mehmethakanyel/Flytech/WhatsApp Image 2023-06-27 at 12.40.13.jpeg

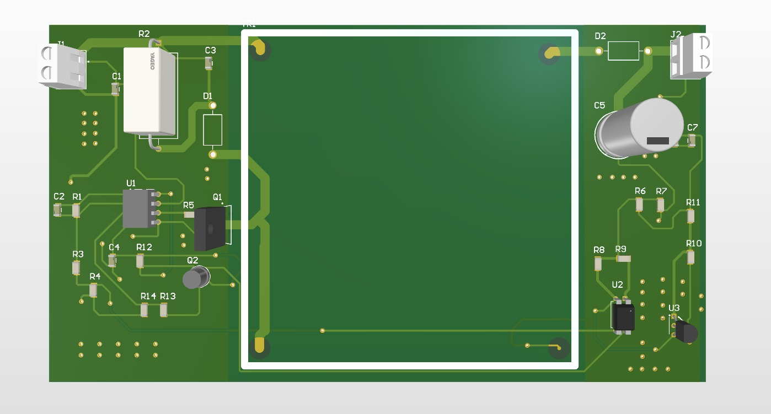
WhatsApp Image 2023-06-27 at 12.40.13.jpeg
