mehmethakanyel/Flytech/README.md

# Flytech
Simulation report: https://docs.google.com/document/d/1wn0tQVHkpxJtkFoidh_2tNkKYAAwz3BNU8IfM2yoR5c/edit#
Final report:  https://docs.google.com/document/d/1T_zZ1rMvK4J-9SenWcKEVHj9yXU3YNR3/edit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
