mehmethakanyel/Flytech/Final_report_magnetic_design.docx

### Core

The core is selected as 00K3515E090 [1]. Our converter has high frequency with a small number of turns, which means the core losses are expected to be the dominant power dissipation component. E cores are better at radiating the core losses than toroid cores albeit worse at radiating the copper losses. Therefore, an E core with the smallest size in the stock is selected.

### Turns Ratio and Magnetizing Inductance

If the duty cycle is assumed to be 0.4, switching frequency 100 kHz and efficiency 0.85, then

V_o =(N_2)/(N_1)(DV_(in))/(1-D)η=(N_2)/(N_1)(0.4⋅12)/0.60.85=48

(N_2)/(N_1)=7

I_(Lm,on) =(P_o)/η/V_(in) D=(48_o)/0.85/12⋅0.4=11.8A

If turns are taken as N_1 =5 , N_2 =35 :

I_1 N_1 =11.8⋅5=59AT

At which point, A_L =135nH/T^2

L_m =A_L N_1 ^2 =3.375μH

In order to stay in CCM:

L_(m,min) =((1-D)^2 R)/(2f)((N_1)/(N_2))^2 =((0.6)^2 48)/(200k)(1/7)^2 =1.76μH<3.375μH

### Wire Selection

Primary RMS current is calculated as,

I_(1,rms) =√(I^2 _(Lm,on) D)=7.46A
I_(2,rms) =√(I ^2 _(Lm,off) (1-D))=1.29A

Accordingly, the primary wire is selected as 18 AWG and the secondary 20 AWG. In this case, primary current density is 9.5A/mm^2 and secondary current density is 0.69A/mm^2 . Fill factor is calculated as:

TA/W_a =(35⋅0.5+5⋅0.79)/151=14%

which is much smaller than 1.

DC resistance of the primary wire:

l_1 =2(C+F)N_1 =2(9.35+9.32)⋅5=186.7mm

l_2 =2(C+F)N_2 =2(9.35+9.32)⋅35=1306.9mm

R_(1,DC) =l_1 R_(cu) /l=186.7mm⋅21Ω/km=3.9mΩ

R_(2,DC) =l_2 R_(cu) /l=1306.9mm⋅33Ω/km=43mΩ

δ=75/√f=0.237mm

R_(1,AC) ≃R_(1,DC) =5.9mΩ

R_(2,AC) ≃R_(2,DC) =54mΩ

P_(cu) =P_(1,cu) +P_(2,cu) =R_(1,AC) I^2 _(1,rms) +R_(2,AC) I^2 _(2,rms) =0.0059⋅7.46^2 +0.054⋅1.29^2 =0.42W

Core losses per volume per 100mT at 100kHz is given as 0.8W/cm^3 =0.8mW/mm^3 .

ΔI_(Lm) =V_(in) D/fL_m =12⋅0.4/100k⋅3.375μ=14.2A

ΔB=Δϕ/A_e =Δλ/NA_e =ΔI_(Lm) L_m /NA_e =14.2A⋅3.375μH/5⋅84mm^2 =114mT

P_(fe) =0.8mW/mm^3 ⋅ΔB/100mT⋅V_e =0.8mW/mm^3 ⋅114mT/100mT⋅5830mm^3 =5.32W

As was expected, at such a high frequency, core losses are larger than copper losses and need E core to dissipate its heat. However, the optimum point of operation, where copper losses are equal to the core losses, can be achieved by decreasing the frequency.S

### Test Results

Once the transformer is wound according to the proposed parameters, it is no-load and short-circuit tested from both sides and the results are the following:

Primary no-load test:

L_(1l) +L_(1m) =5.73μH R_1 =0.0747Ω

Primary short-circuit test:

L_(1l) =0.39μH

Secondary no-load test:

L_(2l) +L_(2m) =286μH R_2 =1.8Ω

Secondary short-circuit test:

L_(2l) =29.2μH

Accordingly, transformer parameters are calculated as follows:

L_(1l) =0.39μH L_m =5.34μH

L_(2l) =29.2μH (N_2)/(N_1)=7

Apparently, leakage inductances are around 10% of the magnetizing inductance, which is acceptable if a suitable snubber is selected. Resistances are also measured to be much higher than calculated. The reason might be the proximity effect which is effective in high frequencies, or due to the neglected core resistance.
