mehmethakanyel/Flytech/Nonideal_simulation.docx

Circuit Simulation with Non Ideal Elements

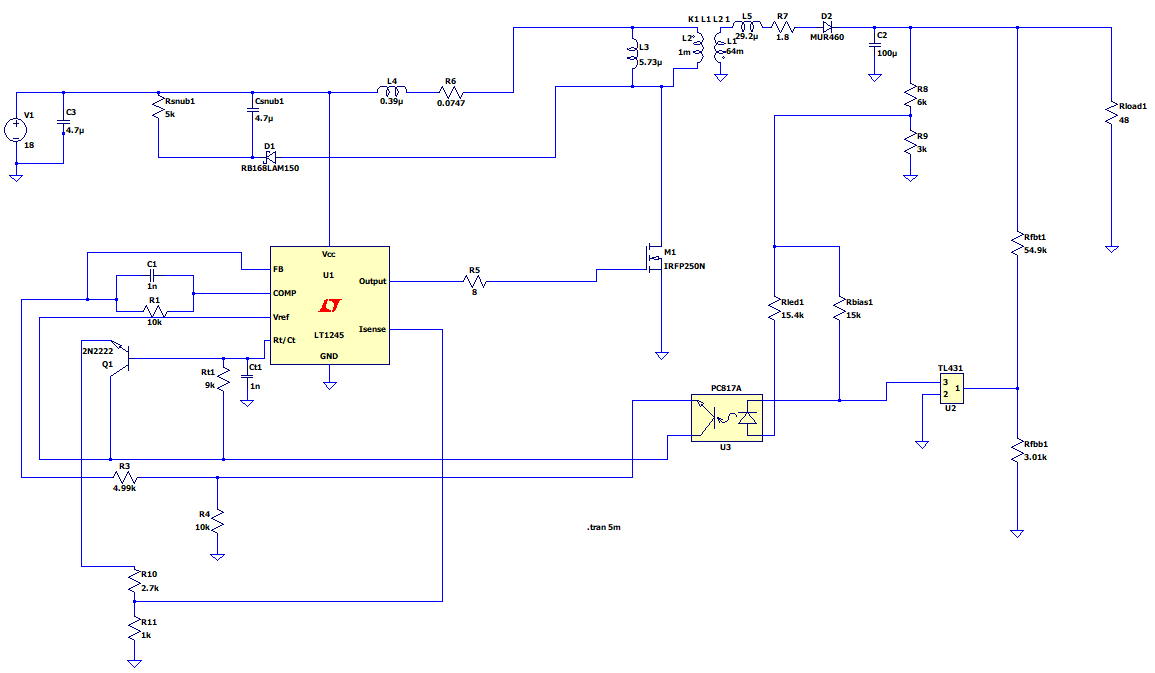
[picture p30: figure]

Fig. 18 Circuit Schematic with Non-Ideal Components

The circuit in Figure 18 is simulated. The controller model LT1245 in the simulation is the equivalent of our controller UC3845. As seen from Figure 20, the output voltage reaches 48V in less than 3ms. Maximum and minimum values are shown in Figure 21, in which the ripple is less than 2%.

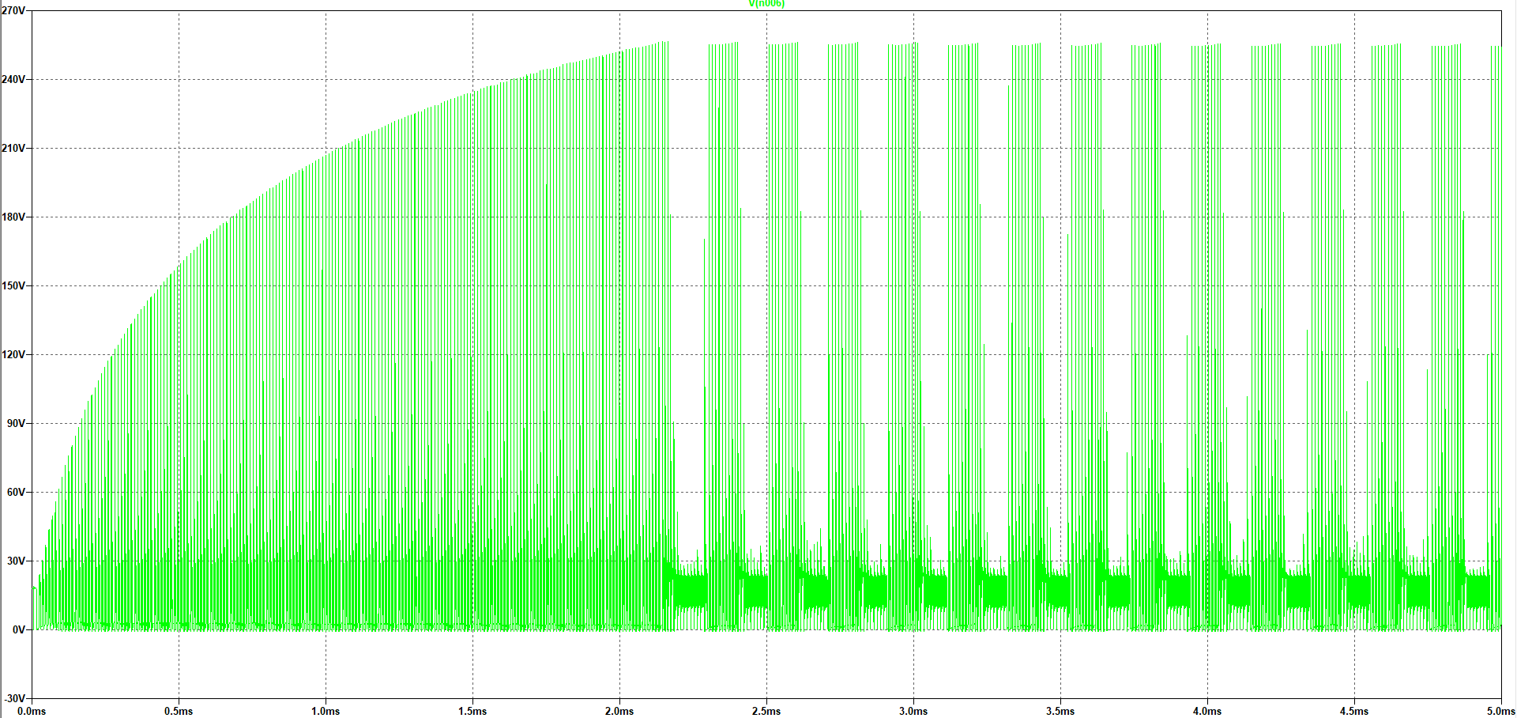
[picture p31: figure]

Fig. 19 MOSFET Drain-Source Voltage

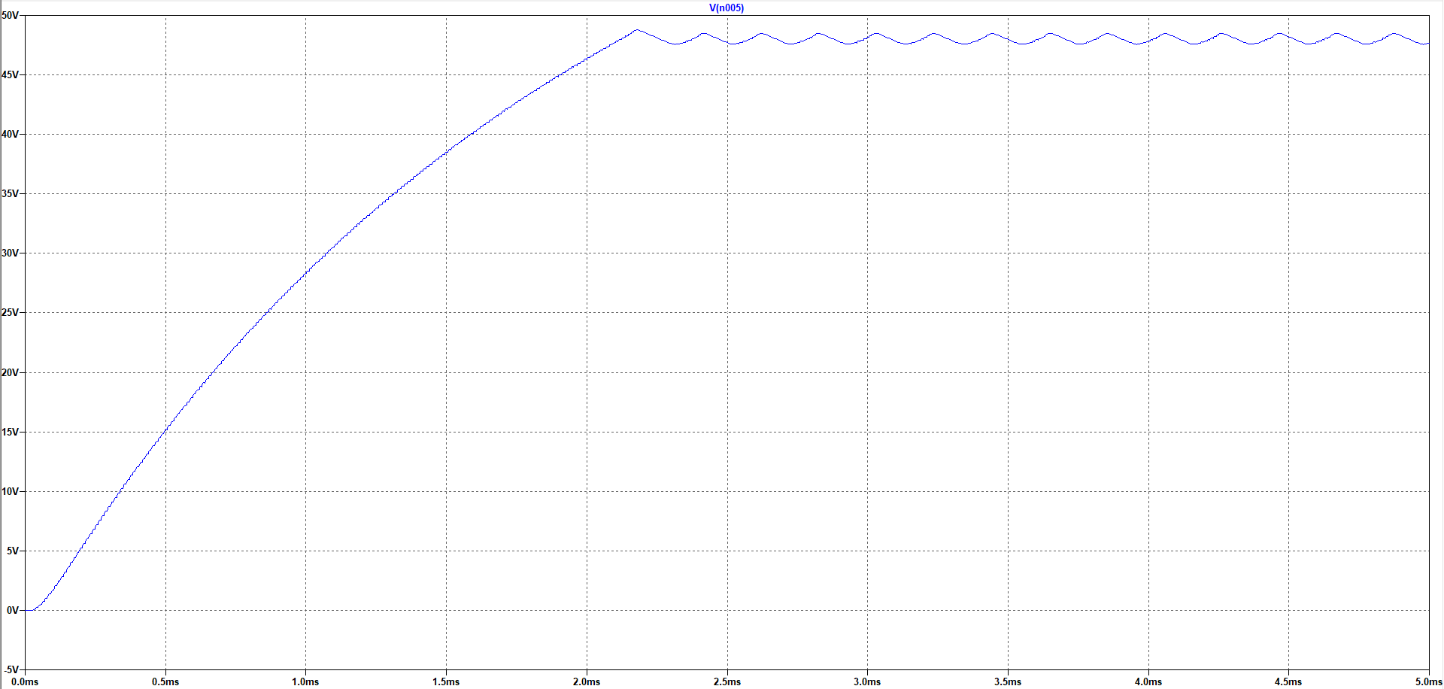
[picture p32: figure]

Fig. 20 Output Voltage Transient

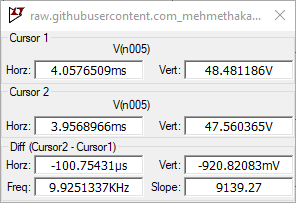
[picture p33: figure]

Fig. 26 Output Voltage Data
