mehmethakanyel/Flytech/Project_report_controller_components.docx

UCx84x Current-Mode PWM Controllers

In this section controller is introduced and circuit calculations are made.

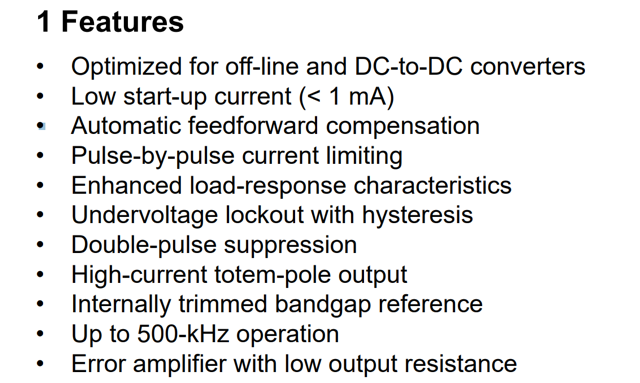
[picture p34: figure]

This controller produced by Texas Instruments however many manufacturers produce the exact product. Analog Devices is one of them it helps us the simulate this circuit with LTspice.

Figure 1: Features and Applications

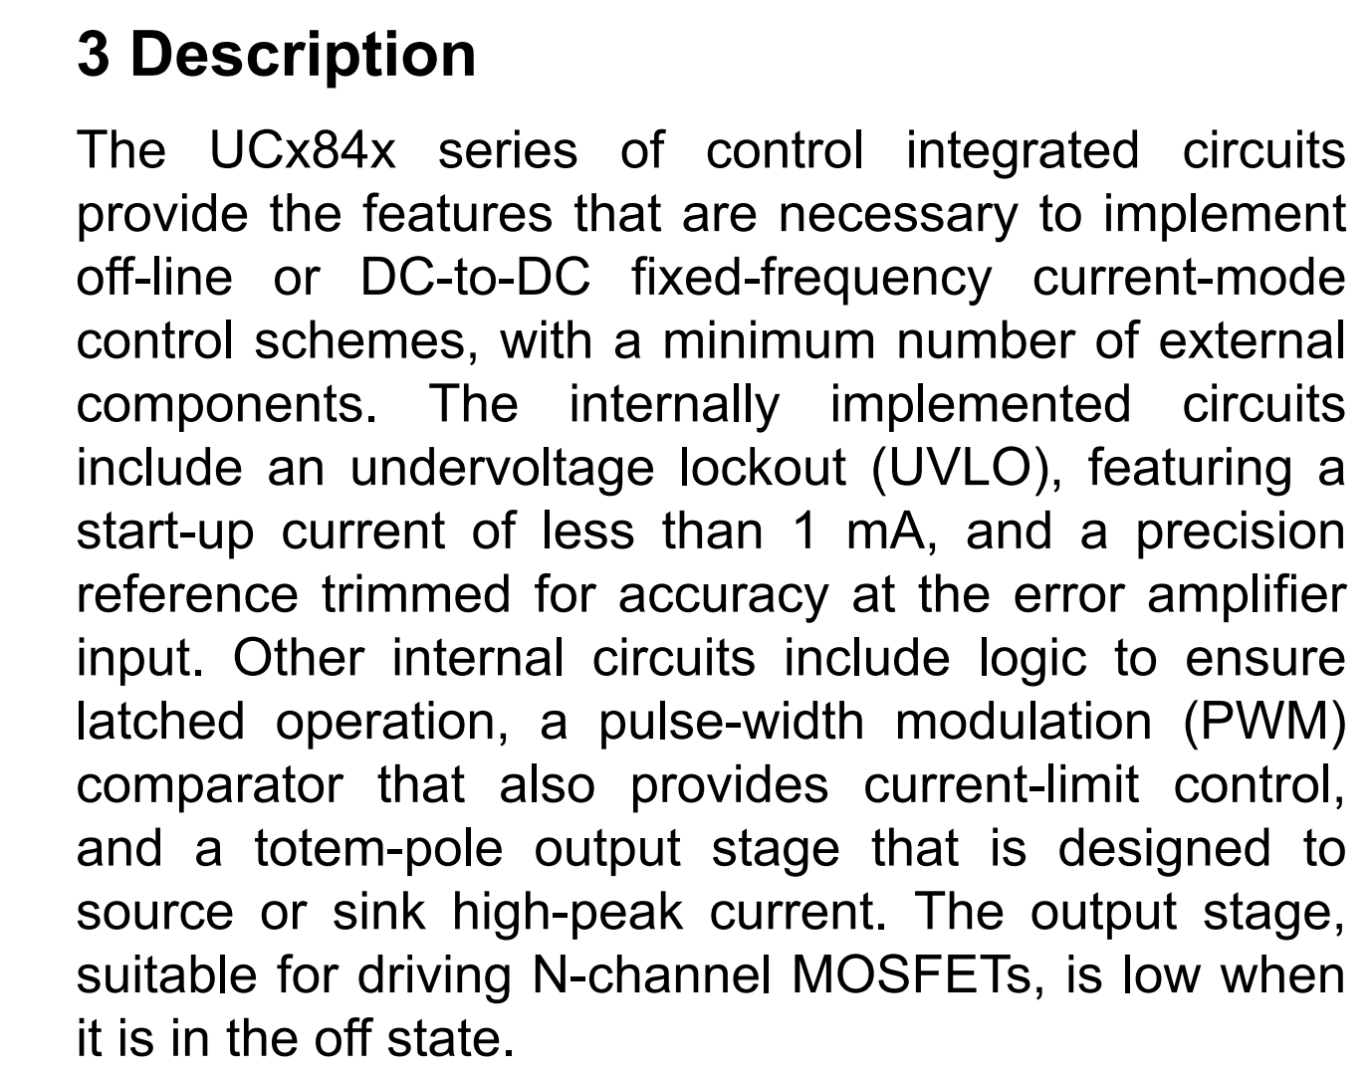
[picture p35: figure]

Figure 2: Description

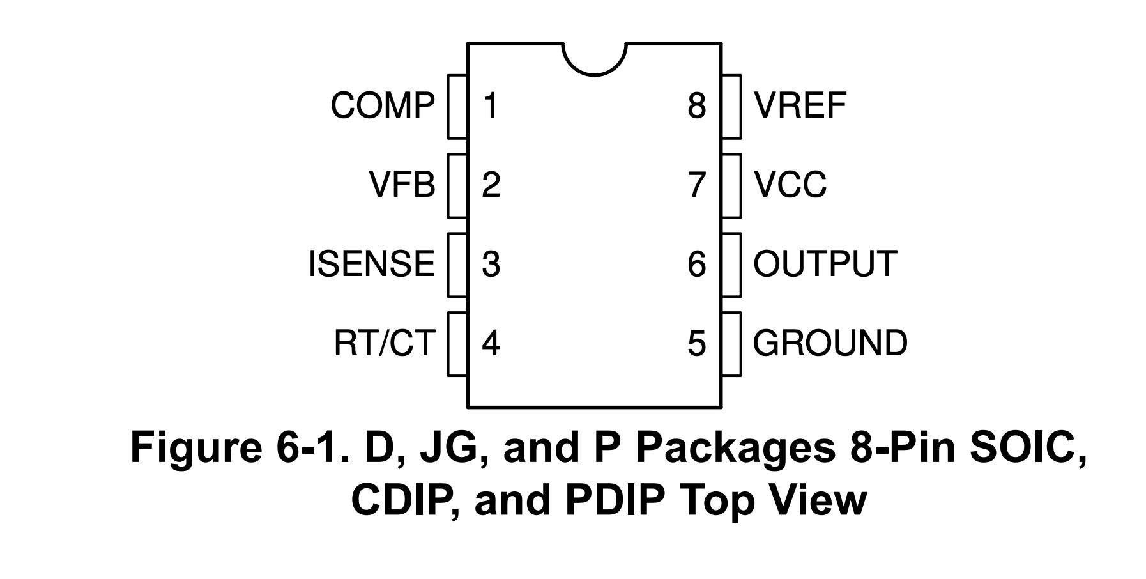
[picture p36: figure]

Figure 3: Pin-Out

For the startup circuit is designed with the Webench power designer and then all of the components are examined. Components which are not necessary for the application is excluded.

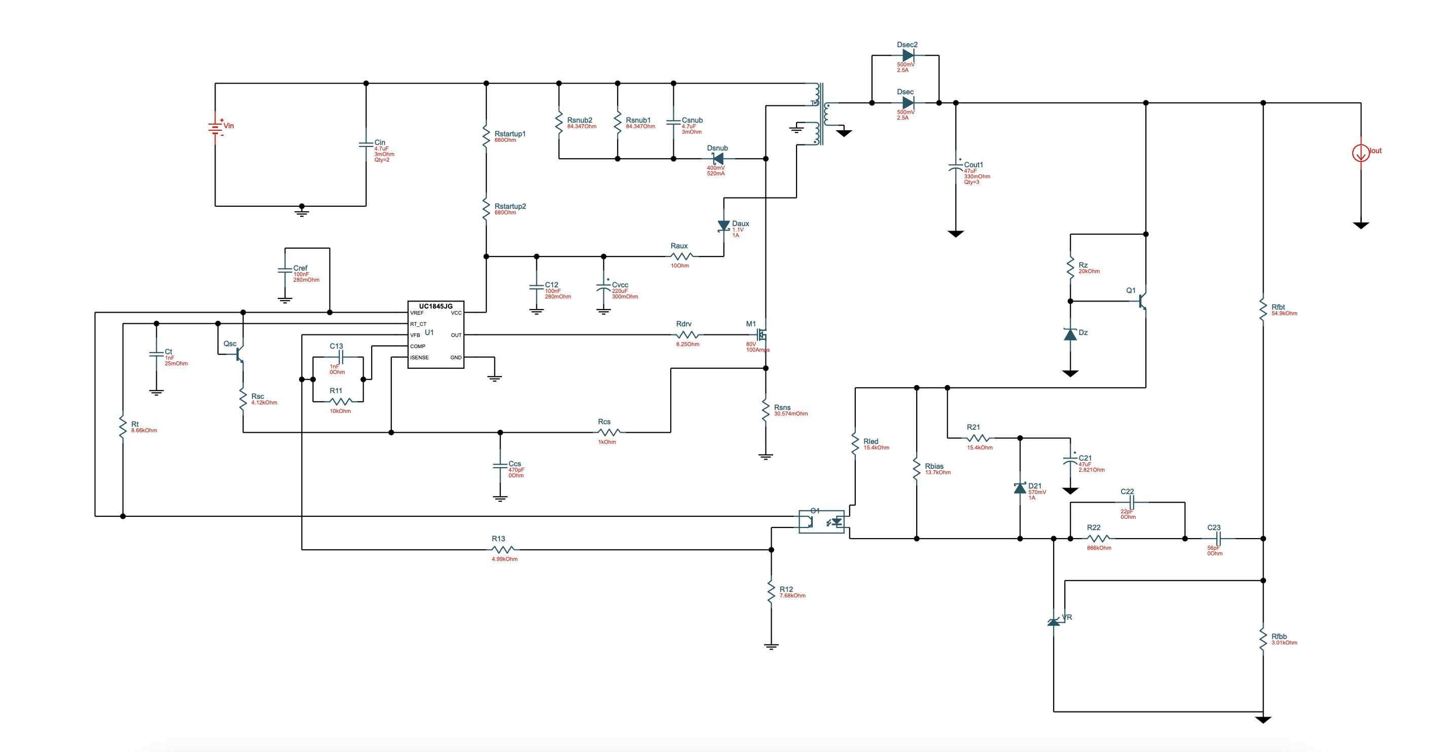
[picture p37: figure]

Figure 4: Webench Circuit Design

Pin Analysis

1. Comp

This pin is defined as error amplifier compensation pin. It helps to control section of the circuit. Phase margin and bode plots can be modified with this pin. However, since it is a complex process, recommended values from TI are used.

Hence 1 nf capacitor and 10 kΩ resistor is used.

2. Vfb

This is a feedback pin which is connected to the internal error amplifier of UC3845.

3. Isense

This is a sense pin for the controller. It is connected to the current sense resistor. However, we did not implement current mode control because there is a power dissipation on the sense resistor which is high for our application. The aimed circuit is the most efficient circuit possible.

For the current mode tried sense resistor value is 30m which helps the circuit not exceeds 27A.

0.030574=(V_(ISENSE))/(I_(SENSE))=(1V)/(I_(PEAK) ×1.2)

I_(PEAK) =27.25 A

I_(SENSE) =32.71 A

P_(sense) =Irms^2 ×R_(sense) =12^2 ×30m =4,32 W

3-4 W power dissipation significantly reduces our efficiency therefore voltage mode is preferred.

It is known that voltage mode control can be applied with any current mode controller. TI describes this operation in the datasheet:

We would need to apply 0.9V peak sawtooth waveform to the input of the current sense pin, which can be accomplished by using a fraction of the oscillator timing capacitor waveform.

For the simplicity we prefer to connect this pin to the ground.

4. RT/CT

The frequency of the oscillator can be estimated with the following equations:

f_(osc) =1.72/(R_(RT) ×C_(CT))

At up to a 100% duty cycle, the UCx842 and UCx843's OUTPUT gate drive's frequency, fSW, is the same as fOSC. At up to 50% duty cycle, the UCx844 and UCx845 frequencies are equal to half of the fOSC frequency.

Moreover, timing resistor should be higher than 5 kΩ.

R_(RT) is chosen as 8.66 kΩ.

f_(OSC) is 100 kHz. However, in order to set switching frequency to 100 kHz; f_(OSC) of the IC is set to 200 kHz.

Therefore,

C_(CT) =1.72/(8.66k×200kHz)=0.993 nF~1 nF

5. Ground

This pin is connected to the ground.

6. Output

This pin produces a gate signal to the MOSFET.

Gate resistor selection is researched. [1]

The procedure is as follows:

1. Determine the oscillator ringing frequency:

Do not connect any external gate resistor to the MOSFET and the measure the ringing frequency.

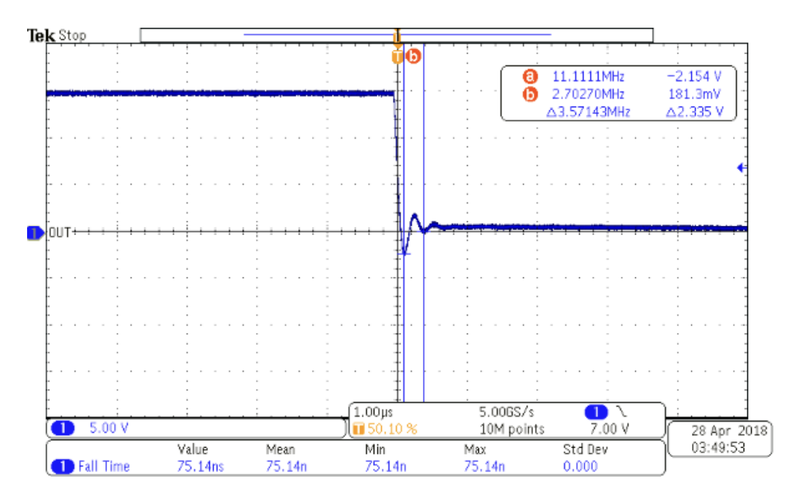
[picture p38: figure]

Figure 5: External Gate Resistor RGATE = 0-Ω

2. Calculate the source inductance L_S according to the MOSFET input capacitance C_(ISS) .

L_S =1/(C_(ISS) ×(2πf_R )^2)

3. Choose a gate resistor with a Q value between 0.5 (critically damped) and 1 (under damped).

Q=(X_L)/(R_G)=(wL_s)/(R_G)

For the predesign stage gate resistor is selected as 8 Ω.

7. VCC

This is the supply voltage pin.

At the webench circuit schematic supply voltage provided with the third winding. However, our input voltage is 12-18 V therefore no additional winding is required. Controller can be supplied up to 30V.

8. VREF

This pin produces 5-V reference voltage. It is connected to the optocoupler.

References

1.Begue, M. (2018). External Gate Resistor Design Guide for Gate Drivers. Application Note:SLLA385.
