mehmethakanyel/Flytech/00K3515E090_bobbin.stl

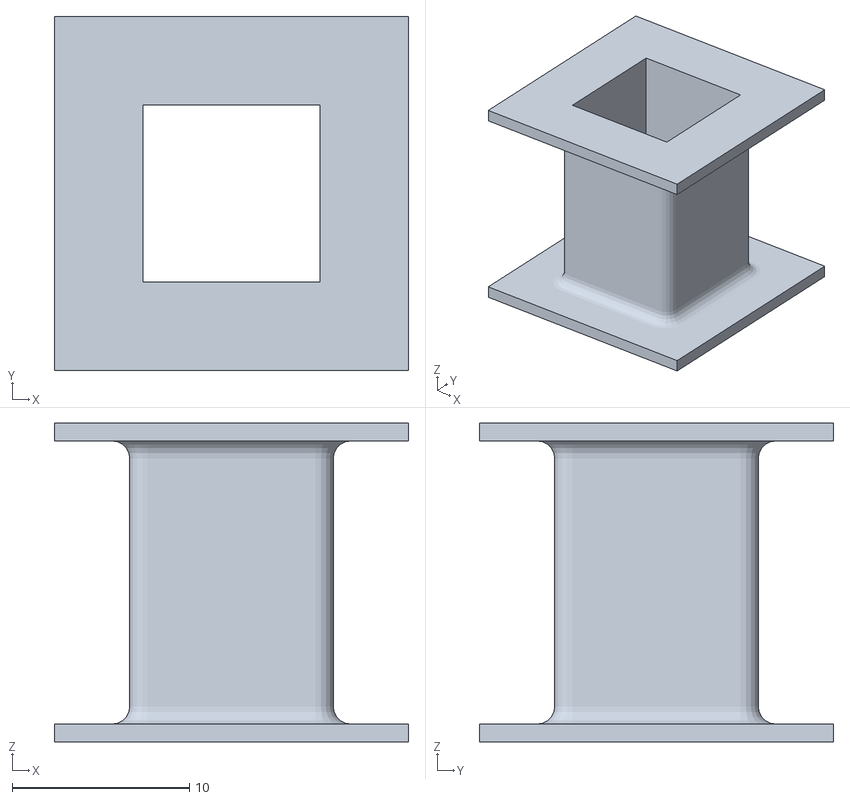
[picture p39: CAD file, 2023-05-21]
00K3515E090_bobbin.stl
20.0 x 20.0 x 18.0
