mehmethakanyel/Flytech/(list of files, cad)

Other CAD files:
00K3515E090_bobbin.prt
