mehmethakanyel/Flytech/project_sonn.asc

C1: cap; 1n
C2: cap; 100µ
C3: cap; 4.7µ
Csnub1: cap; 4.7µ
Ct1: cap; 1n
D1: schottky; RB168LAM150
D2: diode; MUR460
L1: ind2; 64m
L2: ind2; 1m; Rser=.05
L3: ind; 6µ
L4: ind; 0.39µ
L5: ind; 29.2µ
M1: nmos; IRFP250N
Q1: npn; 2N2222
R1: res; 10k
R2: res; 0
R3: res; 4.99k
R4: res; 10k
R5: res; 8
R6: res; 0.0569
R7: res; 2.6
R8: res; 6k
R9: res; 3k
R10: res; 2.7k
R11: res; 1k
Rbias1: res; 15k
Rfbb1: res; 3.01k
Rfbt1: res; 54.9k
Rled1: res; 15.4k
Rload1: res; 48
Rsnub1: res; 5k
Rt1: res; 9k
U1: LT1245
U2: TL431
U3: PC817A
V1: voltage; 18
Named nets: 0
K1 L1 L2 1
.tran 100m
