mehmethakanyel/Flytech/LT1245(UC1845)_Simulation.asc

C1: cap; 1n
C2: polcap; 47µ; Rser=1.2374 Lser=3.5139n mfg="Würth Elektronik" pn="860240372002 WCAP-AT1H 5x11" type="Al electrolytic"
C3: cap; 10µ
C4: cap; 100n
C5: cap; 220µ
Cin1: cap; 4.7µ
Csnub1: cap; 4.7µ
Ct1: cap; 1n
D1: schottky; RB168LAM150
D2: diode; MUR460
D3: schottky; BAT54
D4: zener; TFZV22B
D5: schottky; RBR30T60ANZ
L1: ind2; 49m; Rser=.05
L2: ind2; 1m; Rser=.05
L3: ind; 6µ
M1: nmos; IRF7303
Q1: npn; 2N2222
Q2: npn; BC846B
R1: res; 680
R2: res; 680
R3: res; 10k
R4: res; 10
R5: res; 4.99k
R6: res; 7.68k
R7: res; 8.25
R8: res; 20k
R9: res; 15.4k
Rbias1: res; 13.7k
Rcs1: res; 1k
Rfbb: res; 3.01k
Rfbt1: res; 54.9k
Rled1: res; 15.4k
Rload1: res; 48
Rsc1: res; 4.12k
Rsense1: res; 0.030574
Rsnub1: res; 84.347
Rsnub2: res; 84.347
Rt1: res; 8.66k
U1: LT1245
U2: TL431
U3: PC817A
V1: voltage; 12
Named nets: 0
K1 L1 L2 1
.tran 20m
