mehmethakanyel/Flytech/hw_non_ideal.asc

C1: cap; 10µ
Csn: cap; 15µ
D1: diode; Dideal
D3: diode; Dideal
L1_leakage: ind; 1.97n
L2_leakage: ind; 1.97n
Lm1: ind; 2.25µ
Lp: ind2; 1m
Ls: ind2; 49m
M1: nmos; Si7852DP
R1: res; 48
R1_ac: res; 0.146
R2_ac: res; 0.8
Rsn: res; 10
V1: voltage; 12; Rser=0.0001
Vsw1: voltage; PULSE(0 15 0 1n 1n {D*Ts} {Ts}); Rser=0.0001
Named nets: 0, VOUT, VGS
.tran 1m
K Lp Ls 1
.param D=0.418
.param Ts=10u
.model Dideal D(Ron=0.0001 Roff=100G Vfwd=0)
