mehmethakanyel/Flytech/(commit log)

2023-05-05 Flyback Ideal case
2023-05-05 Mosfet vds calculation
2023-05-05 Diode and mosfet datasheets
2023-05-10 MOSFET Datasheet updated
2023-05-21 added 3d model for bobbin of the first core
    [00K3515E090_bobbin.prt, 00K3515E090_bobbin.stl]
2023-06-11 Altium schematic and layout pdf
2023-06-27 Project report (Altium PCB Design Part )
    with the Heatsink calculations
2023-06-27 Project report (Part: Altium PCB Design)
2023-06-27 final report magnetic design written
